rshorton/linorobot2_hardware/(commit log)

2022-06-14 Motor current publishing changes. Handle encoder noise when motor power disabled
    [firmware.ino, lino_base_config.h]
2022-06-30 Switch to DC brushed motors. Cleanup motor diag messages to allow plotting of pid values.
2022-07-16 Support use of weelye 24V motors with homemade rotation sensors.
2022-07-31 Disable publishing of motor diags
2022-07-31 Increase covariance of odom 'z' twist
    This change was found to reduce the rotational offset noticed in the lidar scans when the robot rotates in a circle. As a result, the scans and localization seem to be more stable when rotating. This probably makes sense since for a skid steer robot, the quality of the odom twist info is poor since by design the wheels will slip/skid. Increasing the odom covariance then gives more priority to the much better IMU measurement of rotation about z.
2023-07-18 IMU related changes
    1. Support magnetometer and publish imu/mag message.
    2. Disable accelerometer data in imu/data message since the values are incorrect. Is it a problem with my IMU or a bug?
    3. Lower publish rate of IMU messages.
    4. Add some test code in calibrate program to exercise accelerometer and magnetometer.
    [firmware.ino]
2023-07-19 Fix magnetometer frame
    The frame appears to be ENU as is.
2023-07-23 Add magnetometer calibration support
    Added test function to output mag output in Uni format for hard iron calibration using the Jupyter notebook referenced on this page: https://learn.adafruit.com/adafruit-sensorlab-magnetometer-calibration/magnetic-calibration-with-jupyter
2026-01-25 WIP ackerman steering support plus various cleanup
2026-01-26 Improve odometry and telop
    * Calc separate speeds for rear motors based on steering angle
    * Revise odometry calcs for Ackerman case
    * Support telop directly using joy messages
2026-01-29 Ackermann steering refinements
    * Add support for reporting steering diag data for plotting and tuning of the related PIDs. This included adding a new elsabot custom message.
    * Support motor with 30:1 gear ratio to improve steering responsiveness
    * Tune steering PID loops
    * Increased sensor reporting rate to 20Hz
    * Added json config file for Foxglove config used during testing of these changes
2026-02-06 Revised published topic names to use /ebot prefix
    Also added timer update to keep clock in sync.
2026-02-15 Support HCSR04 distance sensor mounted on servo
2026-04-14 Update readme and pictures
    These changes correspond to the revised 4-wheel base.
2026-04-30 Use GPIO input to select steering mode
    Removed topic-controlled approach since it was hard to ensure the correct mode was set and re-applied if the micro-ros link reconnected.
    [firmware.ino, lino_base_config.h]
2026-05-10 Range sensor refinements
2026-05-24 Make sure the motor relay is disabled when necessary
    On init, on fatal error, and if connection drops.
    [firmware.ino]
2026-05-24 Don't fail on rmw_uros_sync_session timeout
    Instead try to log a message.
    [firmware.ino]
2026-05-24 Increase odom and sensor publishing rate to 100Hz
2026-06-19 Add I2C bus scan util
2026-06-19 Support VL53L7CX for obstacle detection
    Currently two sensors are mounted on the front of the robot with a 60 deg angle between them. This provide 120 degree of monitoring. The device reports an 8x8 matrix of distance measurements which are reported to ROS as a point cloud.
    A pair will be mounted on the back after more testing of the front sensors.
    Originally an implementation was tested where one device was mounted on a stepper motor (28BYJ48). While this nominally worked (and was fun to implement), the period between measurements was too long (2sec) and the overall solution seemed overly complicated and prone to failure with wired connections constantly flexing. That implemenation w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
    [firmware.ino]
2026-06-19 Revert motor/odom update timer to 20ms period
    [firmware.ino]
2026-07-06 Add support for rear VL53l7CX sensors
2026-09-29 Add deadman functionality for power control
2026-10-07 Disable debug prints
2026-10-07 Refine and disable debug prints
2026-10-07 Change joy enable button for ackerman
    Use LB button.
2026-10-07 Redure power control WD timeout
    Use 300ms instead of 1s.
2026-10-07 Slow down error led pulse sequence
    [firmware.ino]
2026-10-07 Refine encoder cnt config values
